thetemplateblog/openreef/index.md

---
layout: landing
title: OpenReef — open-source automated reef water analyzer
description: Build a lab-grade alkalinity, nitrate and phosphate analyzer for your reef aquarium from off-the-shelf parts. Gran titration, self-blanked colorimetry, full REST API.
---
