thetemplateblog/openreef/docs/index.md

---
layout: single
title: Documentation
permalink: /docs/
---

# Documentation

Complete documentation for building, calibrating, and operating the OpenReef automated Raspberry Pi colorimeter.

## Documentation Sections

### [Introduction](introduction/overview.md)
System overview, measurement theory, and architecture

### [Getting Started](getting-started/raspberry-pi-setup.md)
Complete Raspberry Pi setup guide

### [Assay Protocols](assays/)
- [Phosphate Assay](assays/phosphate.md)
- [Nitrate Assay](assays/nitrate.md)

### [Hardware](hardware/raspberry-pi.md)
Complete Raspberry Pi hardware guide with Adafruit parts list

### [Calibration](calibration/calibration-guide.md)
Calibration procedures and quality control
