thetemplateblog/openreef/assets/img/renders/cell_b_lid.png

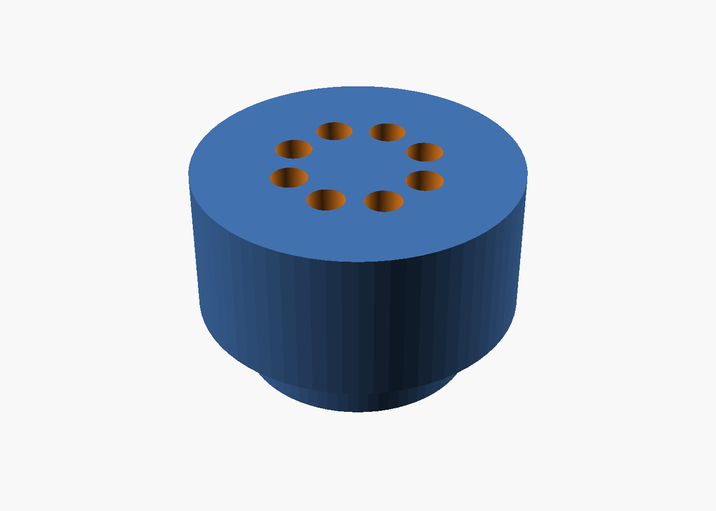
assets/img/renders/cell_b_lid.png
