thetemplateblog/openreef/assets/img/renders/corner_bracket.png

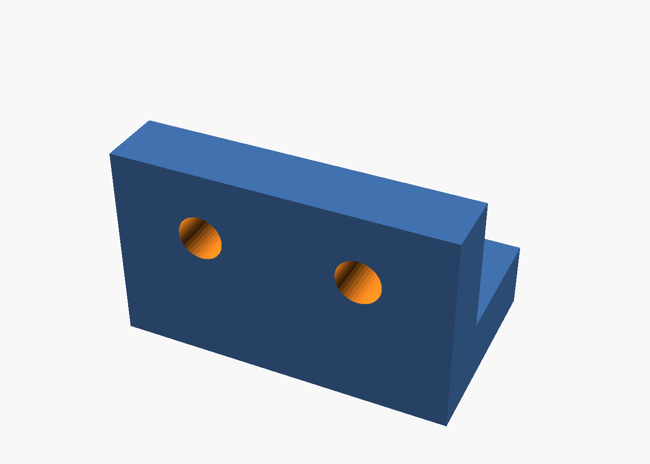
assets/img/renders/corner_bracket.png
