thetemplateblog/openreef/assets/img/renders/syringe_pump_frame.png

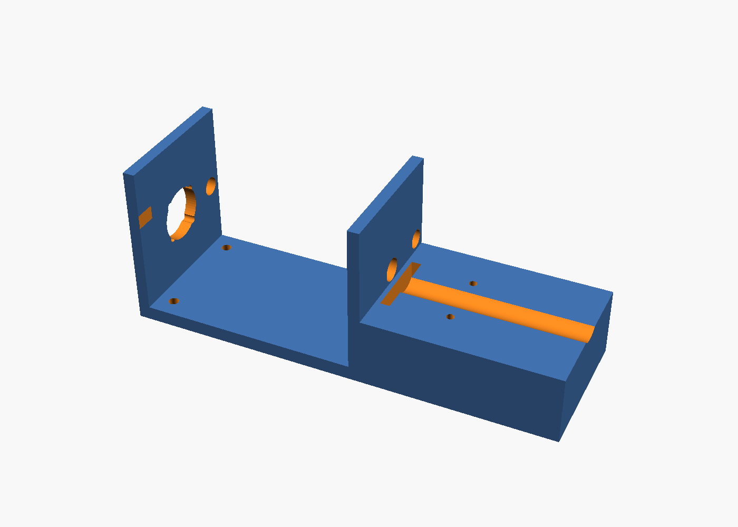
assets/img/renders/syringe_pump_frame.png
