thetemplateblog/openreef/hardware/analyzer/cad/renders/cell_a_cap.png

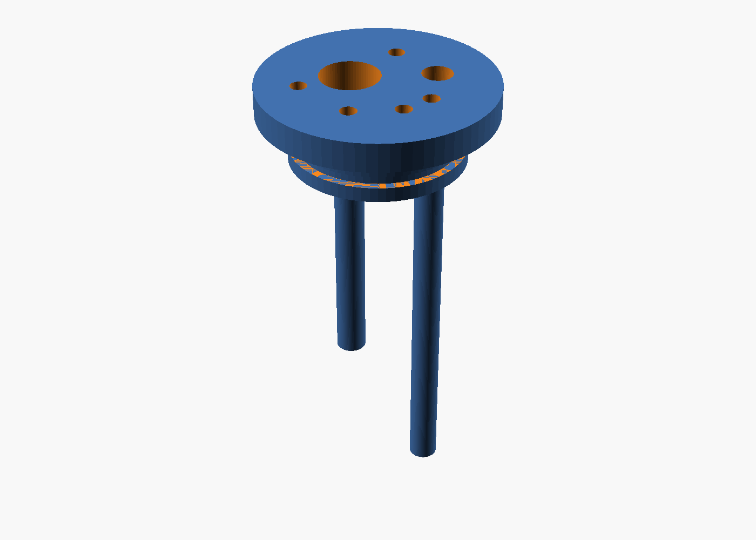
hardware/analyzer/cad/renders/cell_a_cap.png
