thetemplateblog/openreef/hardware/analyzer/cad/renders/enclosure_back.png

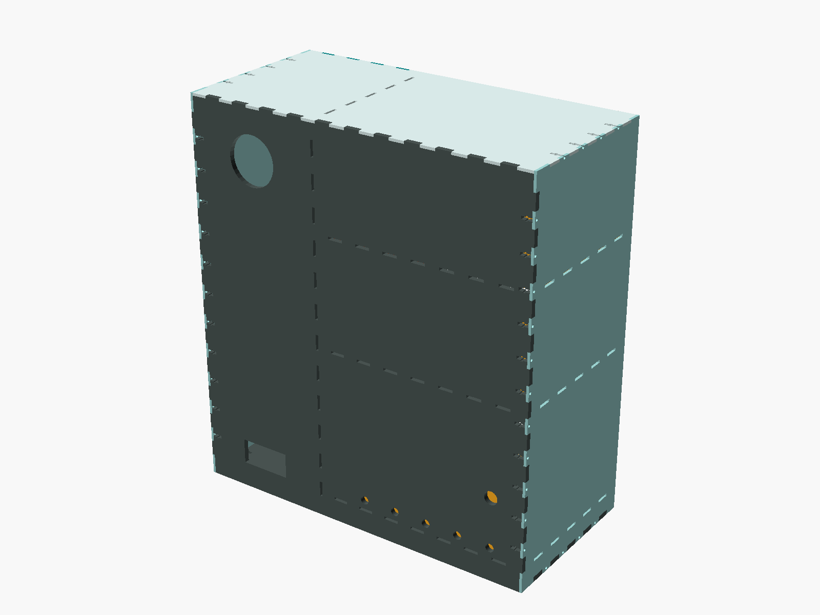
hardware/analyzer/cad/renders/enclosure_back.png
