thetemplateblog/openreef/hardware/analyzer/cad/renders/enclosure_exploded.png

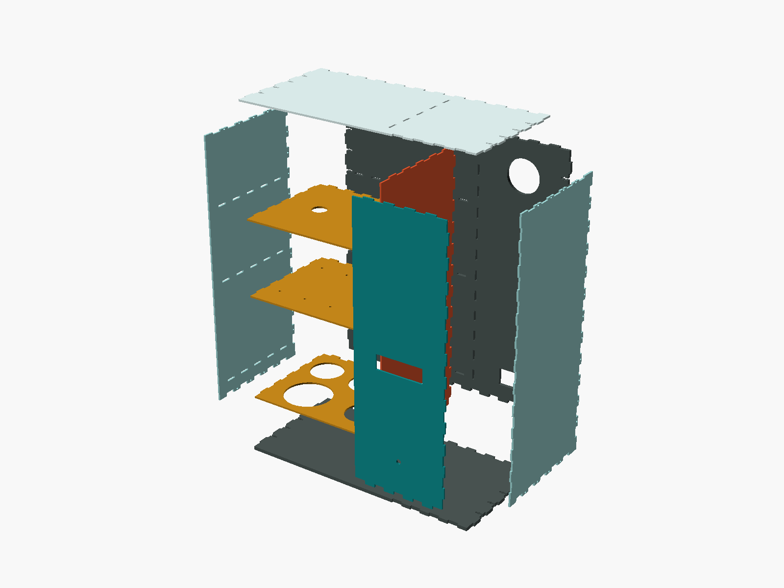
hardware/analyzer/cad/renders/enclosure_exploded.png
