thetemplateblog/openreef/legacy/hardware/cad/enclosure/colorimeter_enclosure_v1r4.obj

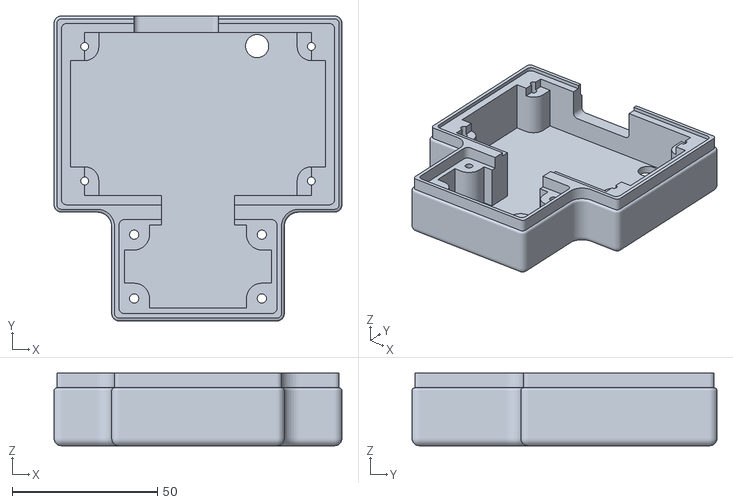
[picture p7: CAD file, 2026-11-08, an earlier design]
legacy/hardware/cad/enclosure/colorimeter_enclosure_v1r4.obj
99.2 x 105.1 x 25.0
