thetemplateblog/openreef/(list of files, cad)

Other CAD files:
legacy/hardware/cad/bottle_caps/bottle_cap_3port.scad
legacy/hardware/cad/enclosure/openreef_enclosure_complete.scad
legacy/hardware/cad/mounting/pump_mount_bracket.scad
