thetemplateblog/openreef/hardware/analyzer/cad/renders/enclosure_assembly.png

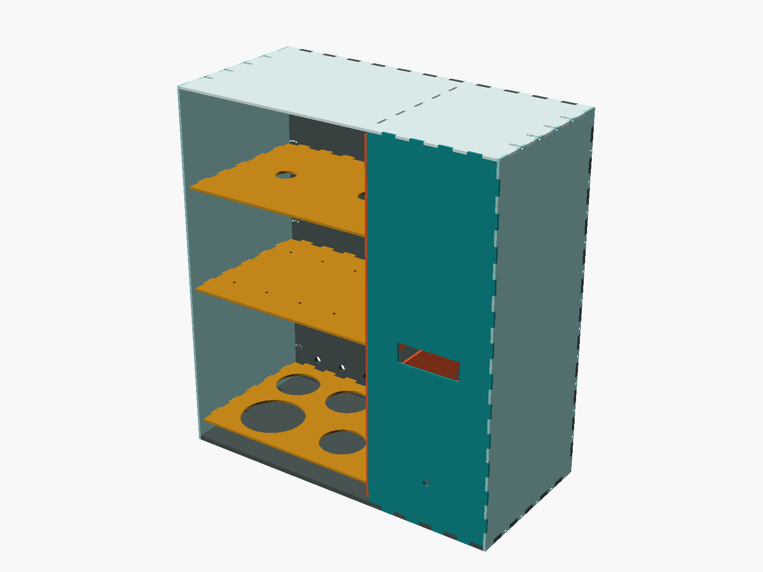
hardware/analyzer/cad/renders/enclosure_assembly.png
