thetemplateblog/openreef/(commit log)

2025-11-19 Initial commit - OpenReef Automated System
    Open-source automated colorimetric water quality testing for phosphate
    and nitrate analysis using PyBadge controller.
    Features:
    - Complete assay protocols for phosphate (625nm) and nitrate (528nm)
    - Hardware documentation and parts list
    - Automation sequence documentation
    - Calibration procedures
    - Jekyll-based documentation website
    Built with passion for the reef keeping and maker communities.
2025-11-19 Remove duplicate title and buttons from homepage
2025-11-27 Add firmware, Change from API to RedSea Phosphate, add a calibration guide
2025-11-28 Fix LED wavelength inconsistencies and clarify phosphate detection
    - Update nitrate/nitrite LED wavelength from 520nm to 528nm in calibration files
    - Clarify phosphate detection wavelengths (880nm optimal, 625nm acceptable)
    - Add comprehensive calibrations.json format documentation
    - Improve wavelength descriptions in test kit comparison tables
    These changes ensure consistency across all documentation and calibration
    files for the colorimetric assay specifications.
2025-11-29 Complete Arduino Giga R1 WiFi port with LVGL UI and auto-calibration
    Core Firmware Features:
    - Port Open Colorimeter from CircuitPython to Arduino C++
    - Implement LVGL v9 UI for 800x480 touchscreen with touch support
    - Integrate TSL2591 light sensor with absorbance/transmittance calculations
    - Add motor controller (PCA9685) with mock mode for testing without hardware
    - Implement solenoid controller for reagent dispensing
    - Create calibration system with JSON data loading from SD card
    - Add built-in fallback calibrations (Phosphate Hanna, Nitrate API, Nitrite API)
    Auto-Calibration Feature:
    - Store standard concentrations in calibrations.json
    - Implement calibration UI workflow: Select test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
2025-11-30 Implement persistent calibration storage and fix sensor saturation
    Major changes:
    - Add persistent calibration storage using QSPI flash (LittleFS)
    - Calibrations stored in last 1MB of 16MB QSPI flash using SlicingBlockDevice
    - Survive firmware uploads and power cycles
    - Auto-format on first use
    - Fix sensor saturation issues
    - Reduce integration time from 500ms to 100ms
    - Use LOW gain (1x) instead of MED to handle always-on LED
    - Add sensor configuration verification and readback
    - Improve calibration workflow
    - Average 10 samples for calibration measurements (matches blank behavior)
    - Auto-return to main menu after successful calibration
    - Show detailed diagnostic output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
2025-12-07 Add Raspberry Pi web interface and update calibrations
    - Add new open_colorimeter_pi web-based interface
    - Flask web server with REST API
    - Modern responsive web UI with gradient theme
    - Real-time sensor measurements with auto-refresh
    - Motor control with slider interface
    - Support for Raspberry Pi OS and Ubuntu Server
    - CircuitPython (Blinka) for hardware control
    - Mock mode for testing without hardware
    - Update PyBadge firmware
    - Add phosphate calibration (0.0, 2.709, 0.0 coefficients)
    - Add motor control libraries (adafruit_pca9685, adafruit_motor)
    - Update configuration files
    - Update Arduino Giga firmware
    - Add Configuration module for settings management
    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
    [Configuration.h]
2025-12-08 Migrate to Raspberry Pi-only platform with web interface
    Major Changes:
    - Remove all PyBadge and Arduino firmware code
    - Update documentation to focus exclusively on Raspberry Pi
    - Add editable calibrations screen to web interface
    - Create comprehensive hardware and setup guides
    Documentation Updates:
    - Update index.md and README.md for Raspberry Pi platform
    - Create docs/hardware/raspberry-pi.md with complete parts list
    - Create docs/getting-started/raspberry-pi-setup.md with setup instructions
    - Fix configuration.json references (now mappings.json, sequences.json, calibrations.json)
    Web Interface Enhancements:
    - Add calibrations editor to Calibrations tab
    - Load/save calibrations via web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
    [Configuration.h]
2025-12-08 Fix documentation issues
    - Add Jekyll front matter to raspberry-pi-setup.md
    - Remove (Optional) from all MCP23017 solenoid driver references
    - Fix 404 links to firmware/open_colorimeter_pi/README.md (point to GitHub)
    - Update docs/introduction/overview.md to Raspberry Pi platform
    - Change API test kits to Red Sea Pro test kits
    - Update phosphate wavelength from 625nm to 880nm (NIR) throughout
    - Remove all (Optional) labels from Solenoid Control sections
2025-12-08 Remove duplicate Raspberry Pi setup guide link
    The setup guide is already covered in the full documentation,
    removed the redundant separate link.
2025-12-08 Simplify site and remove outdated PyBadge documentation
    Removed:
    - PyBadge quick start guide
    - PyBadge hardware parts list
    - Adafruit PyBadge BOM
    - CAD files placeholder (coming soon page)
    - PyBadge automation sequence docs
    Updated navigation menu to simple, functional structure:
    - Get Started (Pi documentation)
    - Hardware Guide (Raspberry Pi)
    - Assays (Phosphate/Nitrate)
    - Calibration
    - GitHub
    Site now focuses exclusively on Raspberry Pi platform.
2025-12-08 Add Save button to update existing command sequences
    Users can now update an existing sequence without creating a new one:
    - Added Save button between Load and Save As buttons
    - Save button updates the currently selected sequence
    - Validates that a sequence is selected before saving
    - Shows clear error messages guiding users to use Save As for new sequences
2025-12-08 Implement template-based sequence system
    Added protected template sequences that cannot be overwritten:
    - Created sequences_templates.json with Phosphate and Nitrate test templates
    - Templates are loaded and merged with user sequences
    - Templates displayed with (Template) label in dropdown
    - Save button blocks modifications to templates (must use Save As)
    - Delete button blocks deletion of templates
    - User sequences saved separately in sequences.json
    - Templates always available but protected from modification
    This prevents accidental overwriting of default test sequences
    while allowing users to create custom variations.
    [app.py, colorimeter.py]
2025-12-08 Implement complete template system for all config files
    Template system now applies to all editable configuration files:
    - Created mappings_templates.json with default device names
    - Created calibrations_templates.json with Phosphate/Nitrate defaults
    - sequences_templates.json already existed
    Backend changes:
    - colorimeter.py: All loaders fall back to template files
    - app.py: /api/config/load falls back to templates when user files missing
    - Added .gitignore rules for user config files
    Frontend cleanup:
    - Removed duplicate sequences/calibrations editors from Config tab
    - Config tab now only shows Device Mappings editor
    - Added loadMappingsEditor() function
    - Updated tab switching to load c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
    [app.py, colorimeter.py]
2025-12-08 Add Jekyll front matter to Raspberry Pi hardware guide
2025-12-08 Remove dead links to deleted adafruit-parts-bom.md
    The adafruit-parts-bom.md file was deleted during site simplification
    but links remained in README.md, index.md, and docs/index.md.
    Removed all references and updated docs/index.md to reflect current
    Raspberry Pi-only structure.
2025-12-10 Add motor speed control to sequence commands
    Motor commands now support variable speed (0-100%):
    - New format: <motor>, <speed>, <time>
    - Example: Sample, 75, 30 (run at 75% speed for 30 seconds)
    - Backwards compatible: <motor>, <time> defaults to 100% speed
    - Negative time still reverses direction
    - Speed is clamped to 0-100 range
    Updated:
    - Command parsing in script.js to handle 3-parameter format
    - Command reference table with new format and old format note
    - Default sequence example with speed values
    - Template sequences with recommended speeds (75% sample, 50% reagent)
    Status output shows speed percentage during execution.
2025-12-10 Remove backwards compatibility for motor commands
    Motor commands now strictly require 3 parameters: <motor>, <speed>, <time>
    Old 2-parameter format (motor, time) is no longer supported.
    Changes:
    - Removed fallback to 100% speed for 2-parameter format
    - Added clear error message when 3 parameters not provided
    - Removed 'Motors (old)' row from command reference table
    - Fixed variable name to use clampedSpeed consistently
    All motor commands must now explicitly specify speed percentage.
2026-11-08 Rebuild OpenReef as the v2 analyzer: alkalinity + nitrate + phosphate
    Start over around the new design: Gran-titration alkalinity, syringe-pump
    dosing, AS7341 self-blanked colorimetry, liquid reagents, a real API.
    - firmware/openreef_analyzer: Python service (hardware layer with Raspberry Pi
    and simulator backends, DIC-corrected Gran fit, colorimetry QC, sequence
    engine with safety interlocks, cron scheduler, SQLite, FastAPI REST +
    WebSocket API, dashboard, Hydros/MQTT/webhook/Prometheus integrations,
    systemd deploy scripts, dev.sh, 8 tests)
    - hardware/analyzer/cad: parametric OpenSCAD syringe pump, cell cap, cuvette
    holder, corner brackets; laser-cut panel layout; wiring diagram;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
2026-11-08 Finger-jointed enclosure panels, 3D assembly and part renders
    - hardware/analyzer/cad/panels.py: parametric tab-and-slot generator (kerf, press-fit, T-slot bolt pockets), through-slots for bulkhead and shelves; replaces the butt-joint layout
    - assembly.py: builds a 3D OpenSCAD assembly from the same geometry for joint checking / STL export
    - renders/: PNG renders of every printed part and the assembled/exploded enclosure
    - syringe_pump.scad: cradle flush with the axis so the barrel sits in a half-pipe
    - docs: enclosure and fluidics pages updated with the joint design and renders; brackets now optional
    Claude-Session: https://claude.a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
2026-11-08 Landing page: parts gallery with renders
    Claude-Session: https://claude.ai/code/session_01KwwRLBE2ovQFXs9FJR8sJS
